cheuksing/flexcut-split-keyboard/keyboard-flex-study/gateron-ks33-drawing.png

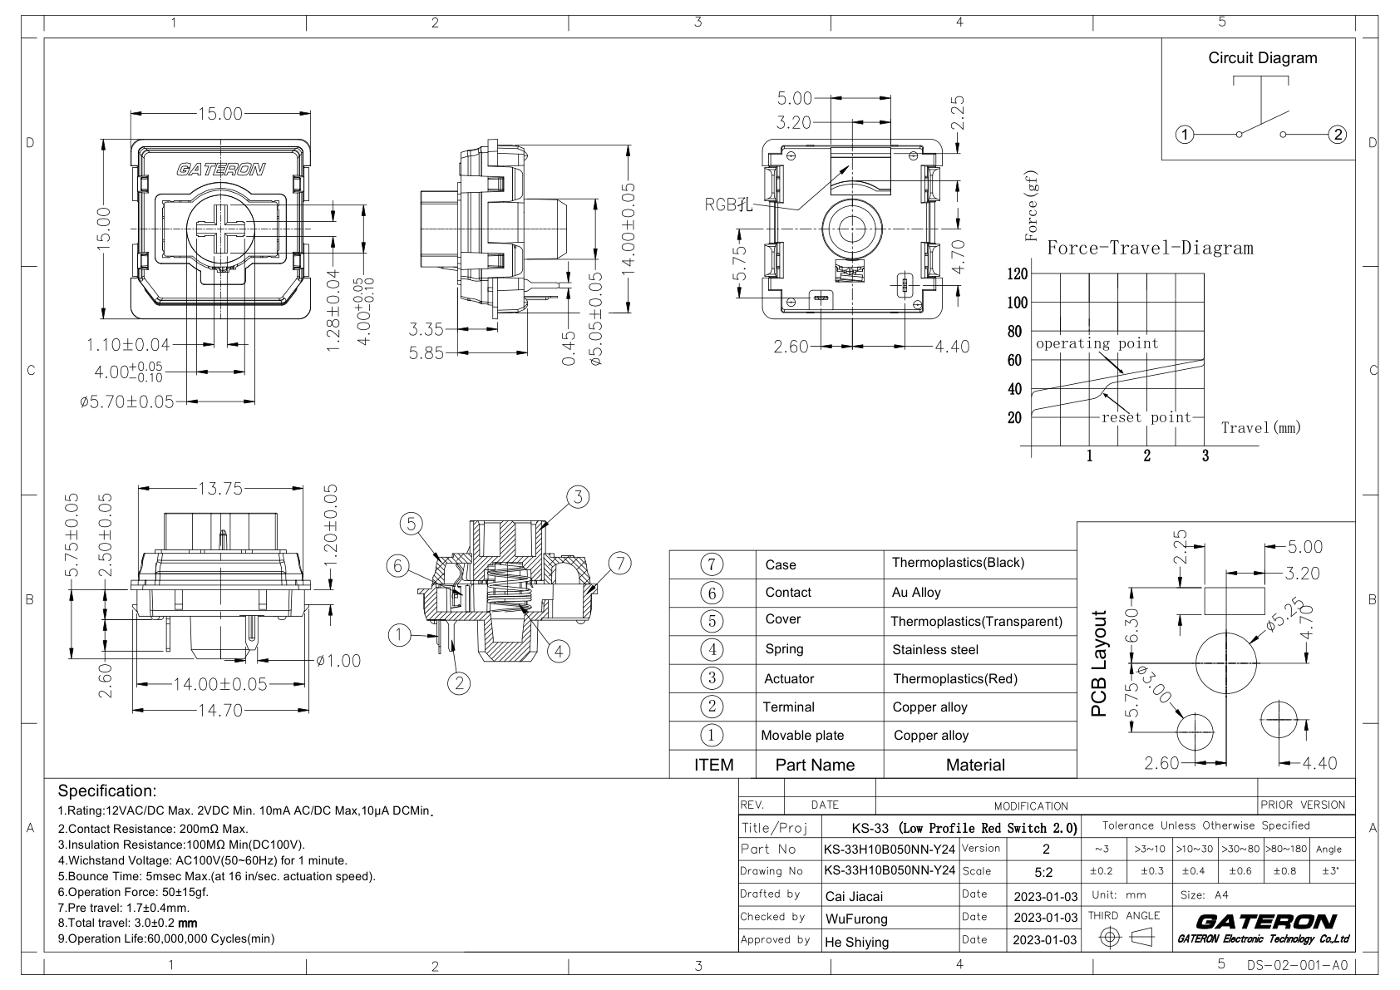
keyboard-flex-study/gateron-ks33-drawing.png
