cheuksing/flexcut-split-keyboard/docs/manufacturing-verification.md

# Manufacturing verification

Run: 2026-10-17. Status: **PASS WITH OPEN REVIEWS**.

Generated by `npm run check`; numeric policy and finding IDs are in [manufacturing-limitations.md](manufacturing-limitations.md).
Results apply only to these exact inputs; changed geometry must be checked again.

Input SHA-256: `5b568d5ad26a4e41a8b3b04801a19de1cf7abdfd3a58f2817962fe7b3043f876`

Toolchain: node v24.14.1, ergogen 4.2.1, python 3.11.2, shapely 2.2.0.

| Footprint | Copper to cut | NPTH land | PTH ring | Shared rail | Adverse rail | 3×3 connections |
| --- | ---: | ---: | ---: | ---: | ---: | --- |
| ks33 | 0.399 mm | 1.574 mm | 0.425 mm | 3.026 mm | 2.626 mm | Pass |
| choc | 0.399 mm | 0.548 mm | 0.425 mm | 2.651 mm | 2.251 mm | Pass |
| mx | 0.399 mm | 0.549 mm | 0.388 mm | 3.691 mm | 3.291 mm | Pass |

The width tests preserve both suspension connections at a 1.30 mm erosion guard and connect every pad/locator lobe to its island at a 1.96 mm guard. These are geometric screens, not measured strength or fatigue ratings.

## Failures

None.

## Full 5×4 Choc half-board

- Actual outline: **98.20 × 88.20 mm**, 1.2 mm nominal FR-4.
- One identical PCB is used twice, switch side up; 20 switches + 20 bottom-side SOD-523 diodes per PCB.
- Five scan nets cover all 20 directed pairs. Parsed schematic wire/pin connectivity matches emitted PCB pads.
- All 40 internal cutouts remain separate; both beams/key, rigid island necks, actual drilled half and adverse route/drill screen pass.
- Minimum actual staggered stationary rail: **2.876 mm**; adverse two-edge screen **2.476 mm**.
- Minimum cut-to-exterior stationary land: **2.700 mm**; adverse two-edge screen **2.300 mm**.
- Diodes lie on their switch islands at (+3.60, 0) mm, rotated 90°; minimum diode copper/edge clearance **0.756 mm**.
- Minimum diode pad to switch solder copper: **1.841 mm**; diode courtyard to switch drill: **0.300 mm**. Hand-soldering access remains a physical check.
- Minimum gasket web before interface-bay relief: **2.276 mm**. Upper and lower switch-area gasket outlines match; both sheets/rib plans remain connected and exclude moving systems.
- Each upper/lower gasket and rib plan encloses **20 separate switch windows**, including the two keys beside the stepped interface bay.
- Support outputs are 2D concepts only: clamps/mounts, diode underside clearance, hard stops, compression and complete case Z geometry remain open.
- Unsupported support tongues are deliberately omitted from the 2D plans, with per-piece area guard; this changes clamp coverage and needs mechanical review: upper_gasket: 0 lobes / 0.00 mm²; lower_gasket: 0 lobes / 0.00 mm²; upper_ribs: 0 lobes / 0.00 mm²; lower_ribs: 0 lobes / 0.00 mm².
- Board is **unrouted**. No native KiCad ERC/DRC has run. MCU pin thresholds, diode voltage margins, multi-key ghosting, firmware and powered/unpowered protection qualification remain open.
- Actual half, passive adapter and two-tab panel are implemented in native CAD; promotional price is not certified.
- `choc5x4_panel` is the only PCB definition/output. Half and adapter checks use exact panel footprints with their existing separated-board perimeter outlines; no separate PCB placements are generated.
- **USB-C interface DESIGN HOLD:** selected pin groups preserve identity with adapter compensation in all four modeled orientations; input margins, rollover and protection qualification remain unresolved. See [interface verification](usb-c-interface-verification.md); `npm run check:interface` is a separate failing electrical release gate.

## Actual breakaway panel and passive adapter

- Bare panel: **98.200 × 99.475 mm**; conservative outline-tolerance envelope 98.600 × 99.875 mm.
- Actual separated-board gap 1.600 mm; two five-hole mouse-bite tabs. Simulated removal leaves two connected boards.
- Adapter 43 components including XIAO header carrier; panel 106 footprints including tabs. Pad clearances, functional drills and courtyards screened on emitted geometry.
- USB4115-03-C is an upright 24-contact connector, 9.3 mm tall. Four shell stakes and two locating holes are included per connector.
- All pick-and-place SMD parts on the half and adapter are on B.Cu. Switches and the separately fitted XIAO are excluded from bottom-side PCBA; JLCPCB assembly acceptance and centroid/stencil review remain open.
- XIAO mounts on two six-pin headers after depaneling, with D0/5V omitted. Its module body overhangs the carrier and needs at least 3 mm standoff; purchased header fit and case Z geometry remain manual.
- Adapter contains series/contact-isolation resistors and TVS only; no LDO, charge pump, reference or active protection IC. TVS does not guarantee MCU fault protection.
- Mouse-bite perforations intentionally have 0.40 mm hole-edge gaps; the separate ≥0.45 mm functional-hole rule remains unchanged.
- The half upper-left connector bay is relieved in both continuous gasket and matching rib concepts. Final clamps, port access and depanel tooling remain open.

## Open reviews and tolerance warnings

- ks33: nominal copper gap passes; conservative minus-0.20 mm screen is 0.199 mm, marginal against 0.20 mm. Do not claim tolerance-guaranteed clearance.
- choc: nominal copper gap passes; conservative minus-0.20 mm screen is 0.199 mm, marginal against 0.20 mm. Do not claim tolerance-guaranteed clearance.
- mx: nominal copper gap passes; conservative minus-0.20 mm screen is 0.199 mm, marginal against 0.20 mm. Do not claim tolerance-guaranteed clearance.
- Native KiCad loading/DRC and final Gerber/drill outputs have not been checked.
- Thin rigid-FR4 beams require CAM acceptance; tool access does not certify breakage resistance.
- Switch fit, case/gasket support, hard stops, fatigue life and neighbour motion need hardware validation.
- The USD 2 promotional price and extra milling fees require a live Gerber quote.
