cheuksing/flexcut-split-keyboard/build/keyboard/choc5x4_panel.kicad_pcb

## KiCad design build/keyboard/choc5x4_panel.kicad_pcb (2026-10-17)

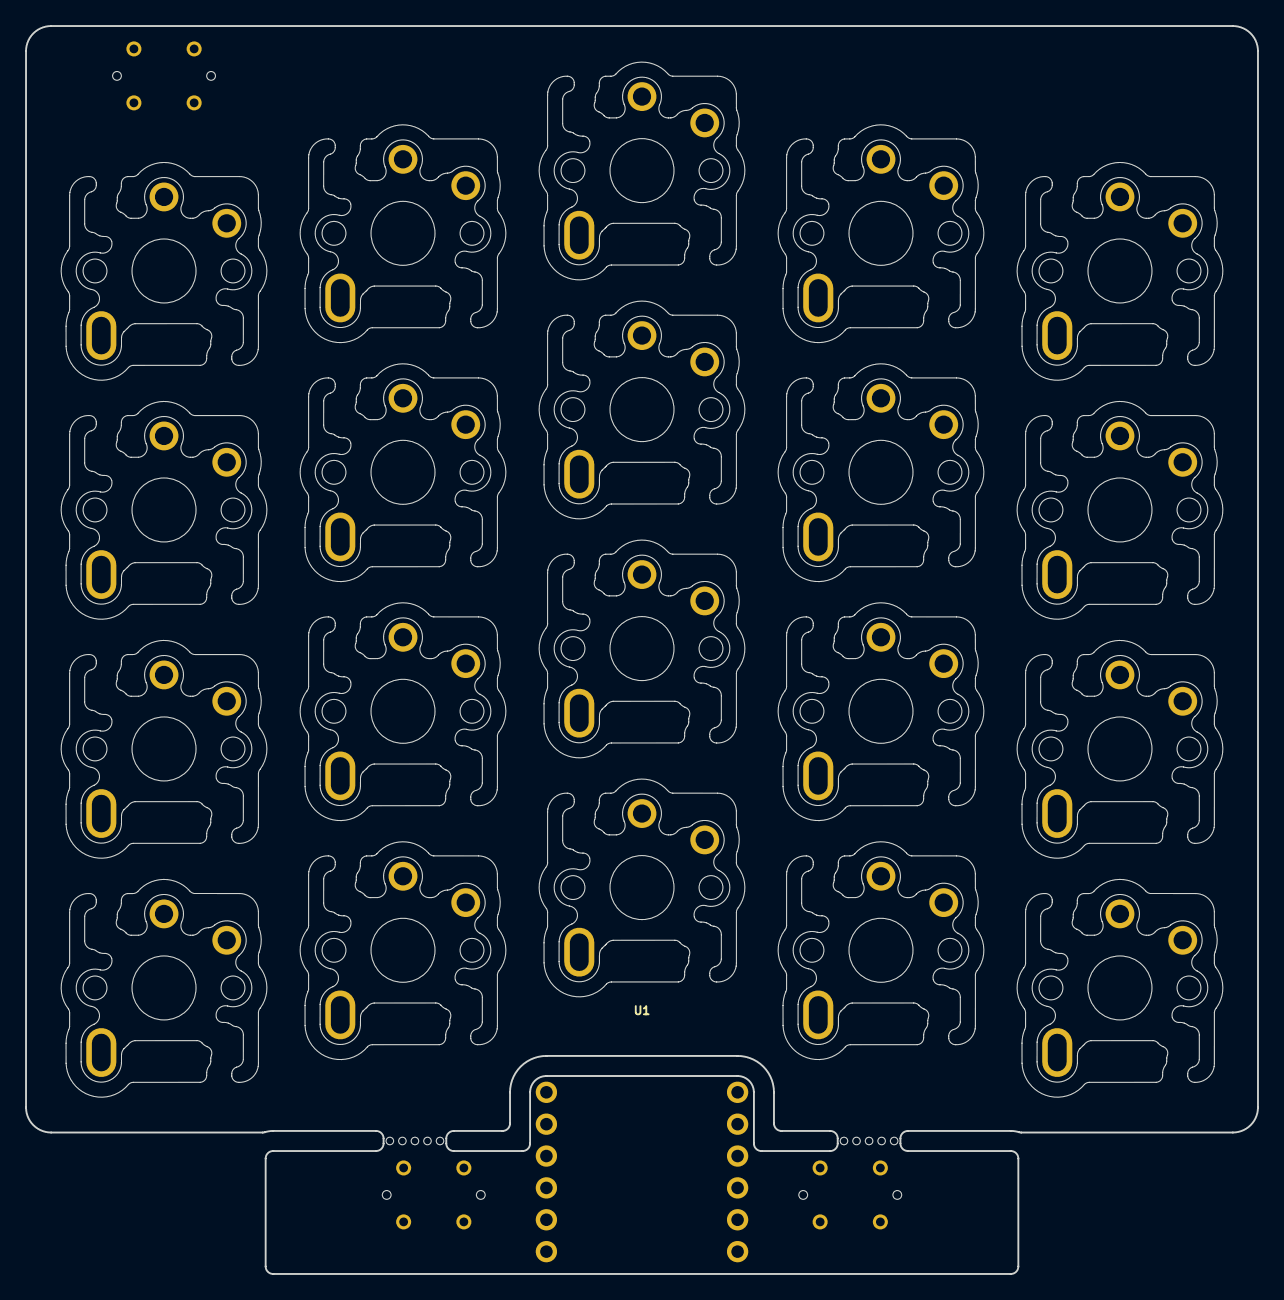
[picture p2: board choc5x4_panel.kicad_pcb from above]

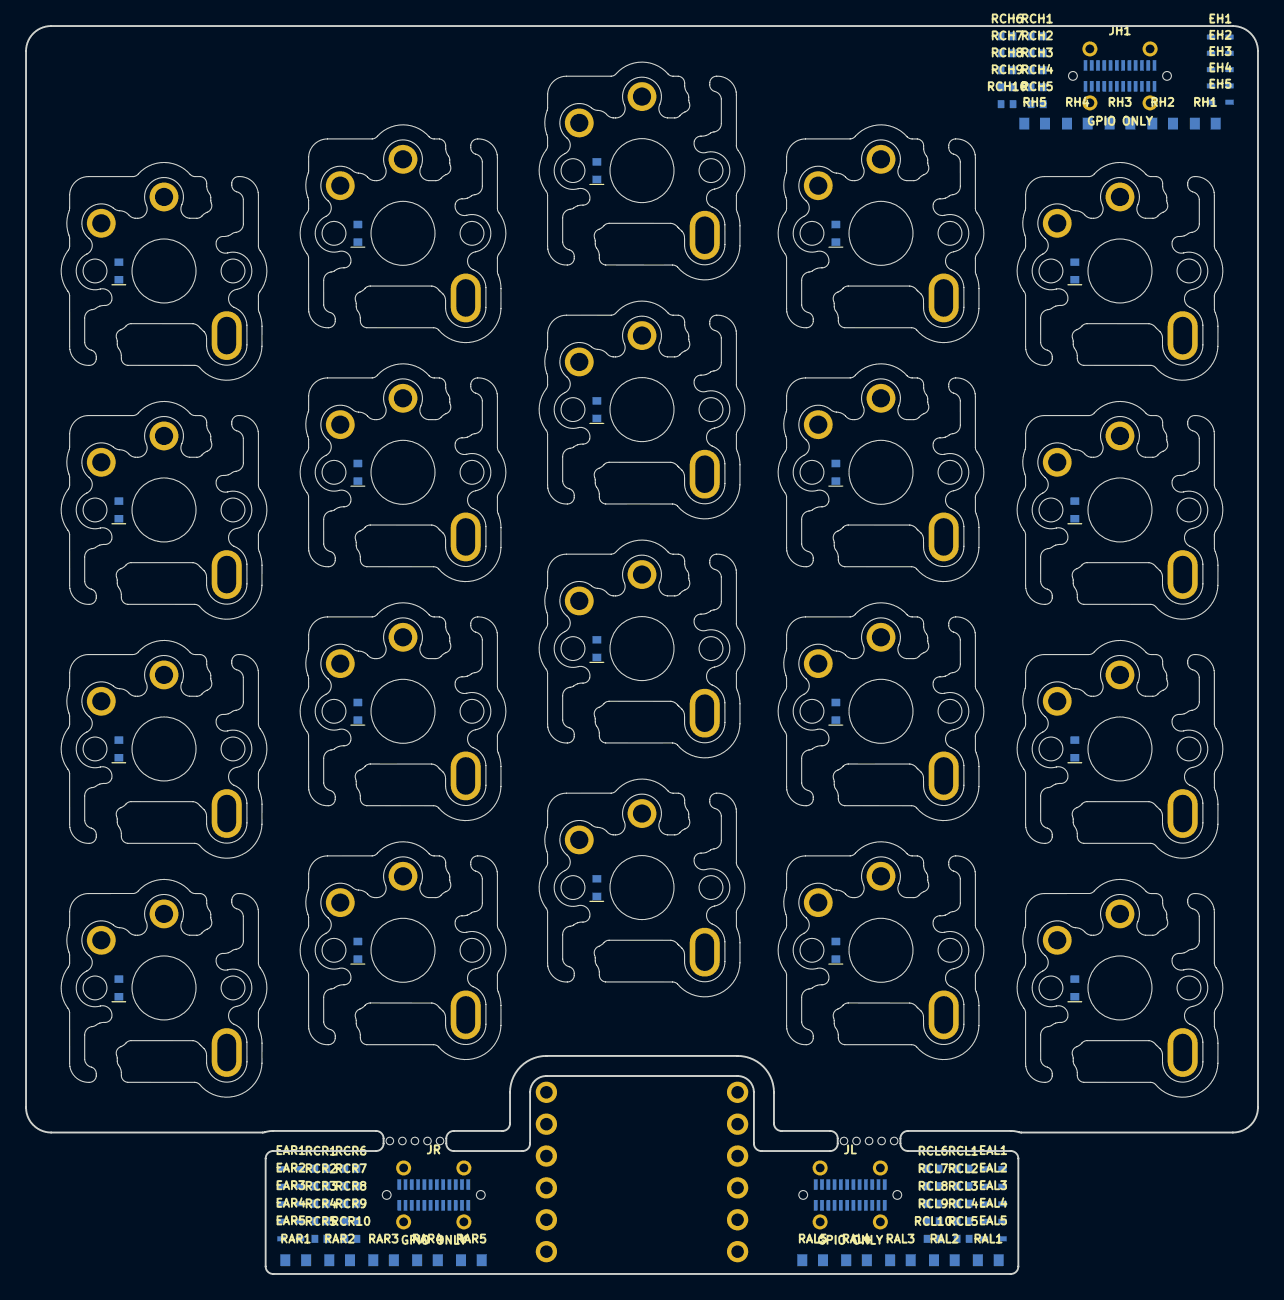
[picture p3: board choc5x4_panel.kicad_pcb from below]

Board: 2 copper layers, 98.2 x 99.5 mm, 106 parts (83 on the bottom side), 82 nets, no tracks yet.

Parts:
D1, D2, D3, D4, D5, D6, D7, D8, D9, D10, D11, D12, D13, D14, D15, D16, D17, D18, D19, D20: 1N4148WT; diode_sod523
EAL1, EAL2, EAL3, EAL4, EAL5: TPD1E05U06DYA; sod523
EAR1, EAR2, EAR3, EAR4, EAR5: TPD1E05U06DYA; sod523
EH1, EH2, EH3, EH4, EH5: TPD1E05U06DYA; sod523
JH1: USB4115-03-C / GPIO ONLY; usb4115
JL: USB4115-03-C / GPIO ONLY; usb4115
JR: USB4115-03-C / GPIO ONLY; usb4115
MB1, MB2: mouse_bites
RAL1, RAL2, RAL3, RAL4, RAL5: 1k; r0603
RAR1, RAR2, RAR3, RAR4, RAR5: 1k; r0603
RCH1, RCH2, RCH3, RCH4, RCH5, RCH6, RCH7, RCH8, RCH9, RCH10: 1k contact isolation; r0402
RCL1, RCL2, RCL3, RCL4, RCL5, RCL6, RCL7, RCL8, RCL9, RCL10: 1k contact isolation; r0402
RCR1, RCR2, RCR3, RCR4, RCR5, RCR6, RCR7, RCR8, RCR9, RCR10: 1k contact isolation; r0402
RH1, RH2, RH3, RH4, RH5: 1k; r0603
SW1, SW2, SW3, SW4, SW5, SW6, SW7, SW8, SW9, SW10, SW11, SW12, SW13, SW14, SW15, SW16, SW17, SW18, SW19, SW20: Kailh Choc V1 / V2; choc
U1: XIAO SAMD21 / mount after depanel; xiao12

Connections:
GND_A: EAL1.2, EAL2.2, EAL3.2, EAL4.2, EAL5.2, EAR1.2, EAR2.2, EAR3.2, EAR4.2, EAR5.2, JL.S1, JL.S2, JL.S3, JL.S4, JR.S1, JR.S2, JR.S3, JR.S4, U1.13
HC0: EH1.1, RCH1.2, RCH2.2, RH1.1
HC1: EH2.1, RCH3.2, RCH4.2, RH2.1
HC2: EH3.1, RCH5.2, RCH6.2, RH3.1
HC3: EH4.1, RCH7.2, RCH8.2, RH4.1
HC4: EH5.1, RCH9.2, RCH10.2, RH5.1
H_A2: JH1.A2, RCH1.1
H_A3: JH1.A3, RCH3.1
H_A8: JH1.A8, RCH9.1
H_A10: JH1.A10, RCH5.1
H_A11: JH1.A11, RCH7.1
H_B2: JH1.B2, RCH2.1
H_B3: JH1.B3, RCH4.1
H_B8: JH1.B8, RCH10.1
H_B10: JH1.B10, RCH6.1
H_B11: JH1.B11, RCH8.1
K_COL0_ROW0: D4.2, SW4.2
K_COL0_ROW1: D3.2, SW3.2
K_COL0_ROW2: D2.2, SW2.2
K_COL0_ROW3: D1.2, SW1.2
K_COL1_ROW0: D8.2, SW8.2
K_COL1_ROW1: D7.2, SW7.2
K_COL1_ROW2: D6.2, SW6.2
K_COL1_ROW3: D5.2, SW5.2
K_COL2_ROW0: D12.2, SW12.2
K_COL2_ROW1: D11.2, SW11.2
K_COL2_ROW2: D10.2, SW10.2
K_COL2_ROW3: D9.2, SW9.2
K_COL3_ROW0: D16.2, SW16.2
K_COL3_ROW1: D15.2, SW15.2
K_COL3_ROW2: D14.2, SW14.2
K_COL3_ROW3: D13.2, SW13.2
K_COL4_ROW0: D20.2, SW20.2
K_COL4_ROW1: D19.2, SW19.2
K_COL4_ROW2: D18.2, SW18.2
K_COL4_ROW3: D17.2, SW17.2
L_A2: JL.A2, RCL1.1
L_A3: JL.A3, RCL3.1
L_A8: JL.A8, RCL9.1
L_A10: JL.A10, RCL5.1
L_A11: JL.A11, RCL7.1
L_B2: JL.B2, RCL2.1
L_B3: JL.B3, RCL4.1
L_B8: JL.B8, RCL10.1
L_B10: JL.B10, RCL6.1
L_B11: JL.B11, RCL8.1
L_C0: EAL1.1, RAL1.2, RCL7.2, RCL8.2
L_C1: EAL2.1, RAL2.2, RCL5.2, RCL6.2
L_C2: EAL3.1, RAL3.2, RCL3.2, RCL4.2
L_C3: EAL4.1, RAL4.2, RCL1.2, RCL2.2
L_C4: EAL5.1, RAL5.2, RCL9.2, RCL10.2
L_M0: RAL1.1, U1.2
L_M1: RAL2.1, U1.3
L_M2: RAL3.1, U1.4
L_M3: RAL4.1, U1.5
L_M4: RAL5.1, U1.6
P0: D8.1, D11.1, D14.1, D17.1, RH1.2, SW1.1, SW2.1, SW3.1, SW4.1
P1: D1.1, D12.1, D15.1, D18.1, RH2.2, SW5.1, SW6.1, SW7.1, SW8.1
P2: D2.1, D5.1, D16.1, D19.1, RH3.2, SW9.1, SW10.1, SW11.1, SW12.1
P3: D3.1, D6.1, D9.1, D20.1, RH4.2, SW13.1, SW14.1, SW15.1, SW16.1
P4: D4.1, D7.1, D10.1, D13.1, RH5.2, SW17.1, SW18.1, SW19.1, SW20.1
R_A2: JR.A2, RCR1.1
R_A3: JR.A3, RCR3.1
R_A8: JR.A8, RCR9.1
R_A10: JR.A10, RCR5.1
R_A11: JR.A11, RCR7.1
R_B2: JR.B2, RCR2.1
R_B3: JR.B3, RCR4.1
R_B8: JR.B8, RCR10.1
R_B10: JR.B10, RCR6.1
R_B11: JR.B11, RCR8.1
R_C0: EAR1.1, RAR1.2, RCR7.2, RCR8.2
R_C1: EAR2.1, RAR2.2, RCR5.2, RCR6.2
R_C2: EAR3.1, RAR3.2, RCR3.2, RCR4.2
R_C3: EAR4.1, RAR4.2, RCR1.2, RCR2.2
R_C4: EAR5.1, RAR5.2, RCR9.2, RCR10.2
R_M0: RAR1.1, U1.7
R_M1: RAR2.1, U1.8
R_M2: RAR3.1, U1.9
R_M3: RAR4.1, U1.10
R_M4: RAR5.1, U1.11
SHIELD_H: EH1.2, EH2.2, EH3.2, EH4.2, EH5.2, JH1.S1, JH1.S2, JH1.S3, JH1.S4
